homesensors/hardware/carrier_ble/carrier_ble.kicad_pcb

## KiCad design PCB Design/PCB Design.kicad_sch

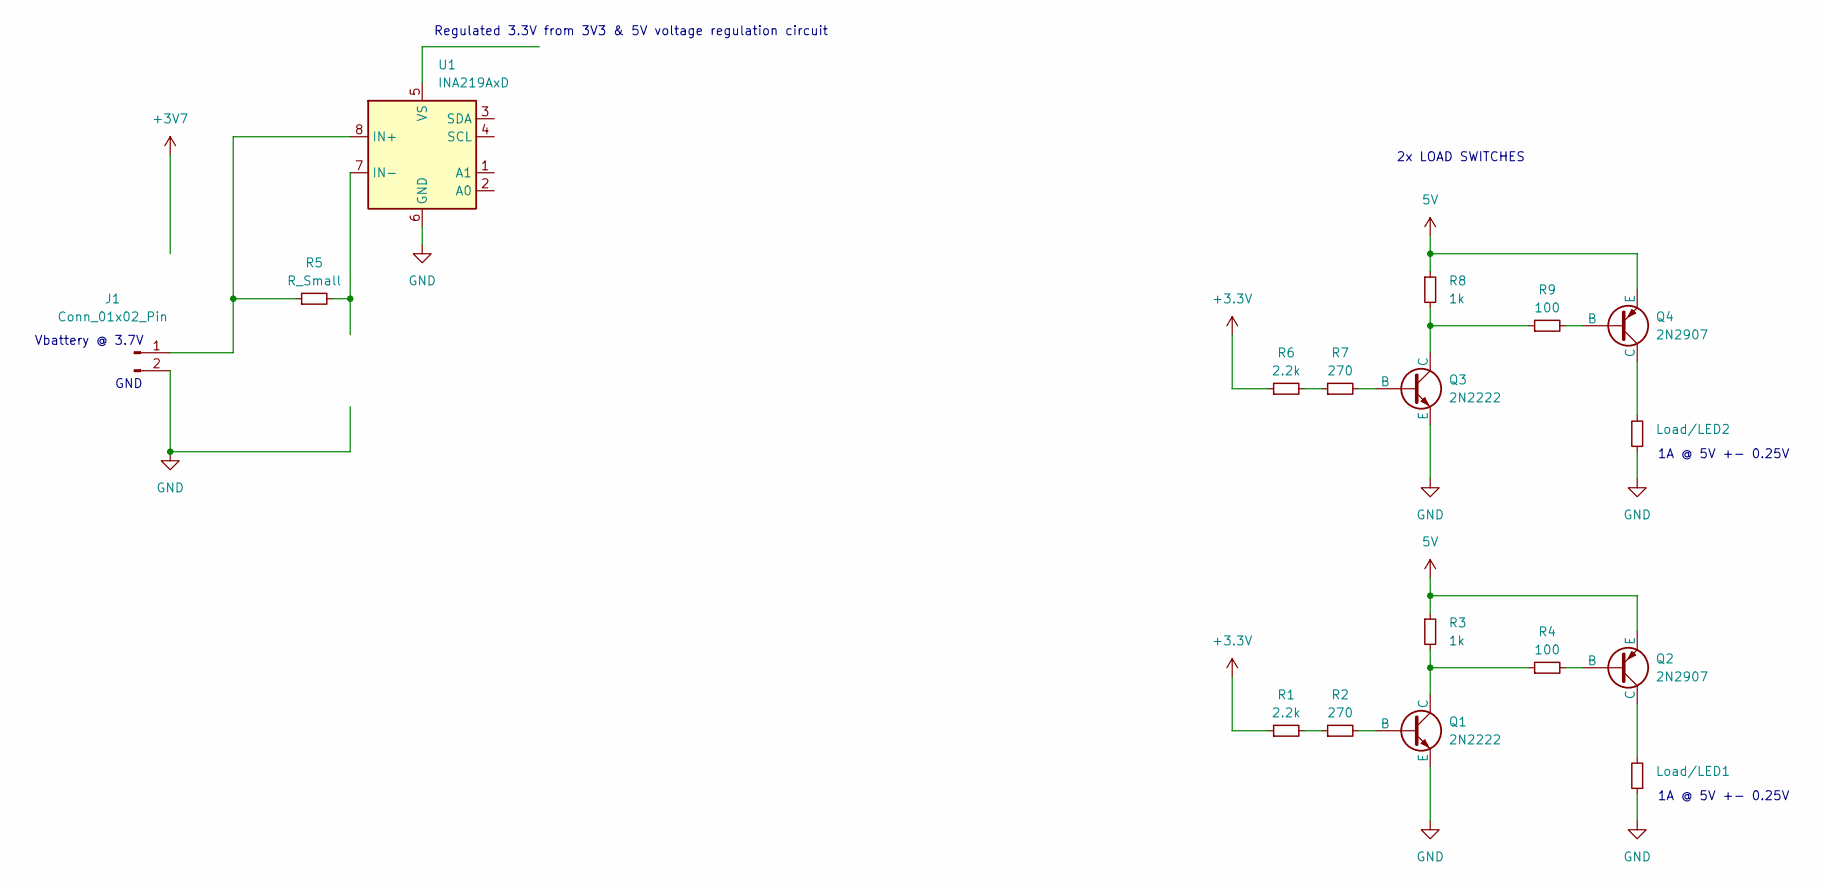
[picture p1: schematic PCB Design.kicad_sch]

Parts:
J1: Conn_01x02_Pin
Load/LED1, Load/LED2: (no value)
Q1, Q3: 2N2222
Q2, Q4: 2N2907
R1, R6: 2.2k
R2, R7: 270
R3, R8: 1k
R4, R9: 100
R5: R_Small
U1: INA219AxD; SOIC-8_3.9x4.9mm_P1.27mm

Connections:
5V: Q2.3 (E), Q4.3 (E), R3.1, R8.1
+3.3V: R1.1, R6.1
GND: J1.2, Load/LED1.1, Load/LED2.1, Q1.3 (E), Q3.3 (E), U1.6 (GND)
unnamed: J1.1, R5.1, U1.8 (IN+)
unnamed: Load/LED1.2, Q2.1 (C)
unnamed: Load/LED2.2, Q4.1 (C)
unnamed: Q1.1 (C), R3.2, R4.1
unnamed: Q1.2 (B), R2.2
unnamed: Q2.2 (B), R4.2
unnamed: Q3.1 (C), R8.2, R9.1
unnamed: Q3.2 (B), R7.2
unnamed: Q4.2 (B), R9.2
unnamed: R1.2, R2.1
unnamed: R5.2, U1.7 (IN-)
unnamed: R6.2, R7.1

Notes on the sheet:
1A @ 5V +- 0.25V
GND
Regulated 3.3V from 3V3 & 5V voltage regulation circuit
Vbattery @ 3.7V
2x LOAD SWITCHES
