homesensors/hardware/(commit log)

2026-05-13 Initial commit: ble_door_sensor PCB Rev A (as fabricated)
    Snapshot of the ble_door_sensor KiCad project as it stood when the
    custom DoorMonitor PCBs were sent to fab. This is the "Rev A"
    baseline of the user's own board — separate design from the
    MB2157 / NUCLEO-WB09KE dev board, which served only as ST's
    reference design during firmware bring-up.
    Contents:
    - ble_door_sensor.kicad_pro/.kicad_sch/.kicad_pcb — current project
    (TCS40DPR Hall on PA0, active-low LED on PA1, STM32WB09KEVx in
    QFN32, MLPF-NRG-01D3 BLE matching network, CR2032 holder).
    - ble_door_sensor.kicad_dru — custom design rules.
    - ble_door_sensor.csv — BOM export from KiCad.
    - TCS40DPR_STM32WB09_v9.kicad_sch — l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
    [TCS40DPR_STM32WB09_v9.kicad_sch, ble_door_sensor.csv, ble_door_sensor.kicad_pcb, ble_door_sensor.kicad_sch]
2026-05-14 Public-prep: LICENSE (CERN-OHL-P-2.0) + public README
    Step A prep for moving this repo to public github.com/homesensors/hardware:
    - Add CERN-OHL-P-2.0 LICENSE (full text embedded). Permissive open
    hardware: derivatives can be modified, fabricated, and sold without
    copyleft obligations; only attribution + licence preservation
    required.
    - Add public-facing README with:
    - revision history (Rev A fabricated; Rev B in progress, folds in
    VDDA_VCAP cap + battery divider)
    - what's in the repo (KiCad project files, BOM, future fab/ and
    bom/ dirs for ready-to-order artefacts)
    - fab quick-start (Gerber export + JLCPCB/PCBWay path)
    - design notes (key components, MLPF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
2026-05-14 Rev B: VDDA_VCAP cap + battery divider + JST-MX 4P connector
    PCB Rev B (title block "1.1/B", comment "Added: GPIOs connector.").
    Boards ordered from fab. Folds in everything that was hand-reworked
    on Rev A plus a new expansion connector for future modularity work.
    Schematic + PCB changes vs Rev A:
    1. **VDDA_VCAP decoupling cap** (0.22 µF) on STM32WB09KEVx pin 28.
    Rev A was missing this — caused HCI Hardware_Code 0x01 on every
    advert TX until hand-soldered. Now built into the layout.
    2. **External battery-monitor divider**: R1 = 1 MΩ from cell+ →
    midpoint, R2 = 1 MΩ midpoint → GND, C1 = 1 µF X7R as a reservoir
    cap on the R2 side (NOT in series). Midpoint routed to PB1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
    [ble_door_sensor.csv, ble_door_sensor.kicad_pcb, ble_door_sensor.kicad_sch]
2026-05-15 Restructure: lift door_sensor into its own subfolder
    Prepares the hardware repo to host multiple board projects in
    parallel (per the modular architecture in sensorkit's
    docs/modular-spec.md). The current single-purpose door sensor
    project moves into door_sensor/; new top-level README enumerates
    the board family.
    Layout after this commit:
    hardware/
    ├── README.md ← NEW: board-family overview
    ├── LICENSE ← unchanged
    ├── .gitignore ← unchanged
    └── door_sensor/ ← all the existing files via git mv
    ├── README.md ← board-specific (was top-level)
    ├──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
    [TCS40DPR_STM32WB09_v9.kicad_sch, ble_door_sensor.csv, ble_door_sensor.kicad_pcb, ble_door_sensor.kicad_sch]
2026-05-15 Rename: motherboard → carrier board; add carrier_ble/ KiCad skeleton
    Two related changes:
    1. Naming change: throughout the docs, "motherboard" / "m/b" → "carrier
    board". The original term "motherboard" leaned toward computer/server
    connotations, while the actual role of this PCB (carrying a radio
    module + providing a socket for extension boards) maps directly to
    the established "carrier board" term used in the mikroBUS spec, in
    the Raspberry Pi CM4 ecosystem, and in Nvidia Jetson SoM designs.
    Top-level README.md board-family table updated:
    motherboard_ble → carrier_ble
    motherboard_wifi → carrier_wifi
    motherboard_zigbee → carrier_zigbee
    m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
    [carrier_ble.kicad_pcb, carrier_ble.kicad_sch]
